bobbycar-graz/bobbycar-emergency-hardware/README.md

# bobbycar-emergency-hardware
This is a little project to control the bobbycar with only one analog stick for emergencies (for example main board-computer/steering wheel failure)

# Screenshot
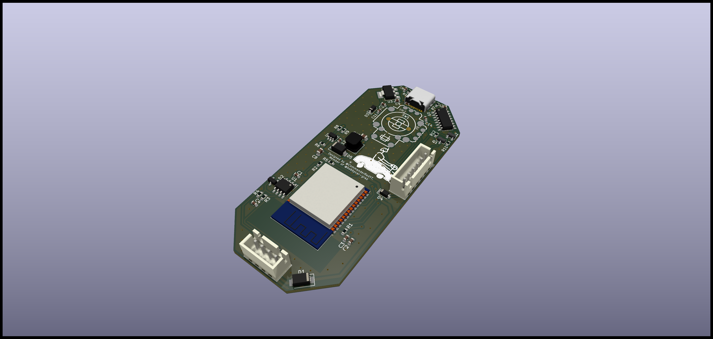
[picture p1: bobbycar-emergency-hardware.png]

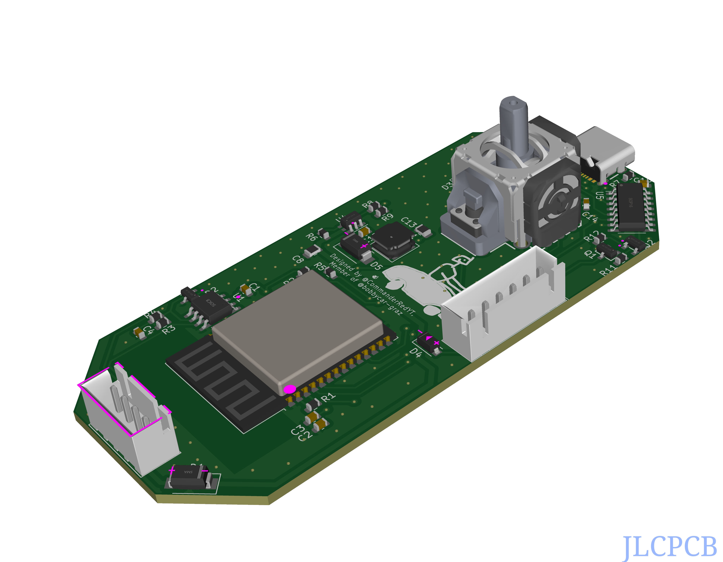
[picture p2: JLCPCB_SCREENSHOT.png]
Screenshot of PCB
