bobbycar-graz/bobbycar-emergency-hardware/kicad/bobbycar-emergency-hardware.kicad_pcb

## KiCad design kicad/bobbycar-emergency-hardware.kicad_pcb (2022-10-07)

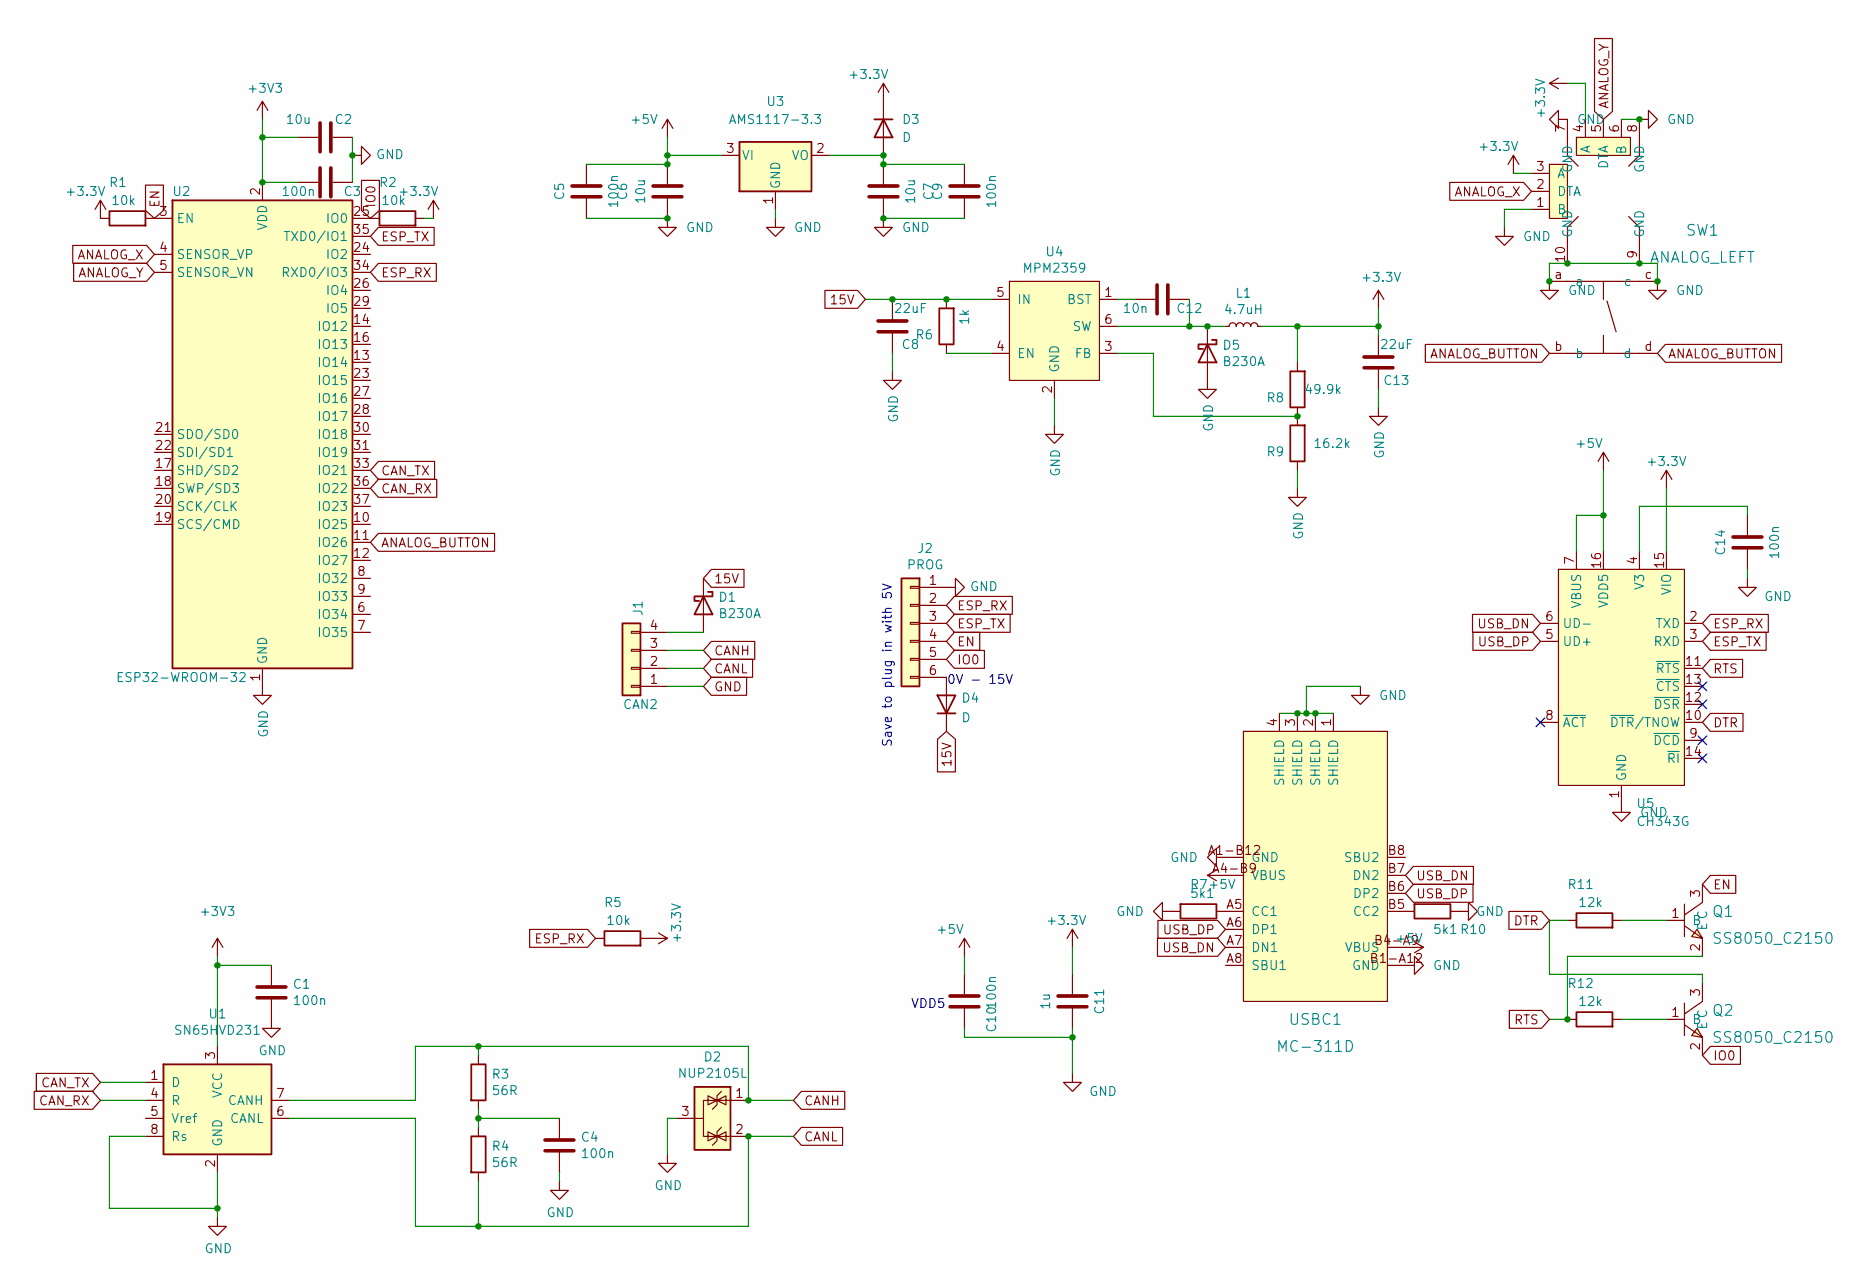
[picture p3: schematic bobbycar-emergency-hardware.kicad_sch]

Parts:
C1, C3, C4, C5, C9, C10, C14: 100n; C_0603_1608Metric; LCSC Part # C14663
C2, C6, C7: 10u; C_0603_1608Metric; LCSC Part # C19702
C8, C13: 22uF; C_0805_2012Metric; LCSC Part # C32375
C11: 1u; C_0603_1608Metric; LCSC Part # C15849
C12: 10n; C_0603_1608Metric; LCSC Part # C57112
D1, D5: B230A; D_SMA; LCSC Part # C12889
D2: NUP2105L; SOT-23; LCSC Part # C284104
D3, D4: D; D_SOD-123; LCSC Part # C8598
J1: CAN2; JST_XH_B4B-XH-A_1x04_P2.50mm_Vertical; LCSC Part # C144395
J2: PROG; JST_XH_B6B-XH-A_1x06_P2.50mm_Vertical; LCSC Part # C144397
L1: 4.7uH; L_5040; LCSC Part # C354606
Q1, Q2: SS8050_C2150; SOT-23-3_L2.9-W1.3-P1.90-LS2.4-BR; LCSC Part C2150
R1, R2, R5: 10k; R_0603_1608Metric; LCSC C25804
R3, R4: 56R; R_0603_1608Metric; LCSC Part # C25196
R6: 1k; R_0603_1608Metric; LCSC Part # C21190
R7, R10: 5k1; R_0603_1608Metric; LCSC C23186
R8: 49.9k; R_0603_1608Metric; LCSC Part # C23184
R9: 16.2k; R_0603_1608Metric; LCSC Part # C22885
R11, R12: 12k; R_0603_1608Metric; LCSC C22790
SW1: ANALOG_LEFT; SW-TH_RKJXV122400D; LCSC Part C2687349
U1: SN65HVD231; SOIC-8_3.9x4.9mm_P1.27mm; LCSC Part # C30530
U2: ESP32-WROOM-32; LCSC Part # C701342
U3: AMS1117-3.3; SOT-223-3_TabPin2; LCSC C6186
U4: MPM2359; SOT-23-6; LCSC Part # C2959845
U5: CH343G; SOIC-16_3.9x9.9mm_P1.27mm; LCSC C2844153
USBC1: MC-311D; USB-C-SMD_MC-311D; LCSC Part C136423

Connections:
15V: C8.2, D1.1 (K), D4.1 (K), R6.2, U4.5 (IN)
+5V: C5.2, C6.2, C10.2, U3.3 (VI), U5.7 (VBUS), U5.16 (VDD5), USBC1.A4-B9 (VBUS), USBC1.B4-A9 (VBUS)
ANALOG_BUTTON: SW1.b, SW1.d, U2.11 (IO26)
ANALOG_X: SW1.2 (DTA), U2.4 (SENSOR_VP)
ANALOG_Y: SW1.5 (DTA), U2.5 (SENSOR_VN)
CANH: D2.1 (K), J1.3, R3.1, U1.7 (CANH)
CANL: D2.2 (K), J1.2, R4.2, U1.6 (CANL)
CAN_RX: U1.4 (R), U2.36 (IO22)
CAN_TX: U1.1 (D), U2.33 (IO21)
DTR: Q2.3 (C), R11.1, U5.10 (~DTR/TNOW)
EN: J2.4, Q1.3 (C), R1.2, U2.3 (EN)
ESP_RX: J2.2, R5.1, U2.34 (RXD0/IO3), U5.2 (TXD)
ESP_TX: J2.3, U2.35 (TXD0/IO1), U5.3 (RXD)
GND: C1.2, C2.1, C3.1, C4.2, C5.1, C6.1, C7.2, C8.1, C9.1, C10.1, C11.1, C13.1, C14.1, D2.3 (A), D5.2 (A), J1.1, J2.1, R7.2, R9.1, R10.1, SW1.1 (B), SW1.6 (B), SW1.7 (GND), SW1.8 (GND), SW1.9 (GND), SW1.10 (GND), SW1.a, SW1.c, U1.2 (GND), U1.8 (Rs), U2.1 (GND), U2.15 (GND), U2.38 (GND), U2.39 (GND), U3.1 (GND), U4.2 (GND), U5.1 (GND), USBC1.1 (SHIELD), USBC1.2 (SHIELD), USBC1.3 (SHIELD), USBC1.4 (SHIELD), USBC1.A1-B12 (GND), USBC1.B1-A12 (GND)
IO0: J2.5, Q2.2 (E), R2.1, U2.25 (IO0)
unnamed: C4.1, R3.2, R4.1
unnamed: C7.1, C9.2, D3.2 (A), U3.2 (VO)
unnamed: C12.1, D5.1 (K), L1.1, U4.6 (SW)
unnamed: C12.2, U4.1 (BST)
unnamed: C14.2, U5.4 (V3)
unnamed: D1.2 (A), J1.4
unnamed: D4.2 (A), J2.6
unnamed: Q1.1 (B), R11.2
unnamed: Q2.1 (B), R12.2
unnamed: R6.1, U4.4 (EN)
unnamed: R7.1, USBC1.A5 (CC1)
unnamed: R8.1, R9.2, U4.3 (FB)
unnamed: R10.2, USBC1.B5 (CC2)
RTS: Q1.2 (E), R12.1, U5.11 (~RTS)
USB_DN: U5.6 (UD-), USBC1.A7 (DN1), USBC1.B7 (DN2)
USB_DP: U5.5 (UD+), USBC1.A6 (DP1), USBC1.B6 (DP2)

Notes on the sheet:
VDD5
Save to plug in with 5V
0V - 15V

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
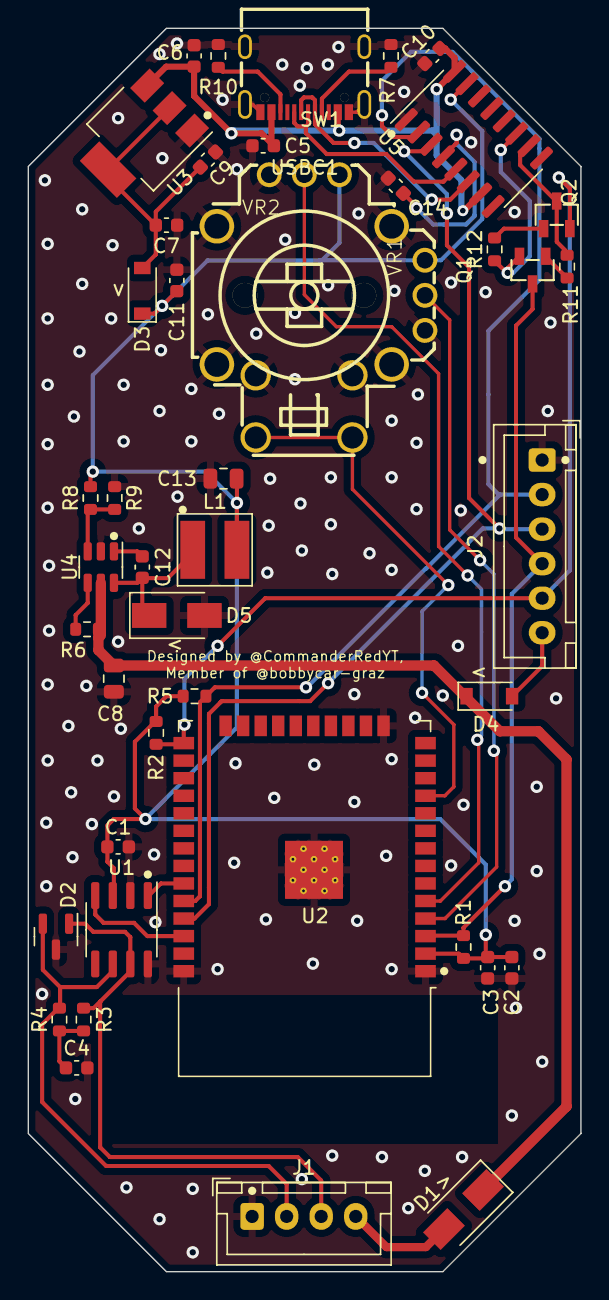
[picture p4: board bobbycar-emergency-hardware.kicad_pcb from above]

Board: 2 copper layers, 40.0 x 90.0 mm, 43 parts (0 on the bottom side), 32 nets.
