bobbycar-graz/bobbycar-emergency-hardware/(threads)

Thread 1 (2022-10-08):

Replace extended components with basic components

peterpoetzi, 2022-10-08:
To save cost, I suggest to change following parts:
- CAN Transceiver C30530, replcae by C12084
- CAN protection diode NUP2105L can be replaced by SMF05CT1G (C15879)
- replace R8 and R9 resistors divider on FB input from 49.9k/16.2k to 75k and 24k, which gives you more accurate 3.3 V instead of the 3.264V the voltage divider currently outputs

So save cost, it would also be possible to populate the J1 CAN Header by hand

CommanderRedYT, 2022-10-10:
I would not order with hand soldering.
