bobbycar-graz/bobbycar-emergency-hardware/(commit log)

2022-10-07 KiCAD gitignore
2022-10-07 PCB Files and more screenshots
    [bobbycar-emergency-hardware-CuBottom.gbr, bobbycar-emergency-hardware-CuTop.gbr, bobbycar-emergency-hardware-EdgeCuts.gbr, bobbycar-emergency-hardware-MaskBottom.gbr, bobbycar-emergency-hardware-MaskTop.gbr, bobbycar-emergency-hardware-NPTH.drl, bobbycar-emergency-hardware-PTH.drl, bobbycar-emergency-hardware-PasteBottom.gbr]
2022-10-07 Fixed JLCPCB, added marks for orientation etc
    [bobbycar-emergency-hardware-CuBottom.gbr, bobbycar-emergency-hardware-CuTop.gbr, bobbycar-emergency-hardware-EdgeCuts.gbr, bobbycar-emergency-hardware-MaskBottom.gbr, bobbycar-emergency-hardware-MaskTop.gbr, bobbycar-emergency-hardware-NPTH.drl, bobbycar-emergency-hardware-PTH.drl, bobbycar-emergency-hardware-PasteBottom.gbr]
